kbloom/7-day-alarm-clock/(commit log)

2020-10-26 Write about changing the i2c address of the snooze button
2020-10-28 Create function prototypes, and reorder declarations to be more coherent.
2020-11-08 Print next alarm
2020-11-09 Time::operator== no longer compares the state field.
    This led to bugs before, so whenever we're care about the state field,
    we should check it explicitly.
2020-11-10 Change the alarm status display to show the weekday and status.
    This removes the alarm time, to prevent confusion with the current time.
    SetAlarm menu can now cycle through all time states.
2020-11-10 Make switch debounce times shorter.
2020-11-10 Print the remaining snooze time as part of the snoozing status message.
2020-11-11 Add shabbat alarms that trigger for one minute only, and don't respond to buttons.
2020-11-20 Bug Fix: make DoubleHighFont print spaces too.
    This way, space-padding actually works.
    [double_high_font.h]
2020-11-22 When exiting state SOUNDING_SHABBAT, drop all button input events.
2020-11-29 Techniques for decreasing the number of setCursor calls when using double_high_digits.h
    Decouple font installation from font writing, so that one can, for
    example write to a buffer class (that implements a partial LCD
    interface), while installing the characters directly on the LCD device..
    Implement write(const char* buffer, size_t size).
2020-11-29 Move PrintTime function into SetTime::Display, the only place it's used.
2020-11-29 Actually print the time faster.
2020-11-29 Print status identifying shabbat alarm when Shabbat alarm is sounding.
2020-12-04 Handle alarms, snooze buttons, and skip buttons while the menu is open.
2021-01-29 Make debounce times longer.
    Make the stop/skip button have a 1 second debounce time, since
    double clicking it is infrequent.
    Make the snooze button have a 200ms debounce time.
2021-01-31 Fix more compile warnings
    [double_high_digits.h]
2021-01-31 Fix more compile warnings
    Some of these affect actual functionality in the uploaded sketch in avr-gcc 10
    (which ships with Manjaro) while not causing problems in avr-gcc 7
    (which ships in the Arduino snap).
    [double_high_digits.h]
2021-12-02 Give the snooze button a long debounce time too.
    This morning I couldn't get it to give me 8 minute snoozes -- only 16 minute snoozes.
2021-12-02 Make the backlight a little bit more orange when one of the buttons is pressed.
2023-11-22 Switch to PlatformIO
2024-01-07 Add debug printing on state transitions.
    This happens to also solve a problem where the alarm
    was constantly restarting. I don't know why. Timing, I guess?
    [alarm_clock.cpp]
2024-09-30 Change alarm length to be length of the MP3.
    I wanted to shorten my alarms to 10 seconds or 30 seconds (since I never
    need a full 5 minute alarm, but if I forget about the alarm for Yom Tov,
    it wakes up my wife and she can't get back to sleep.)
    I couldn't find a reliable way to shorten my alarms down to that length
    aside from this. My current MP3 is about 20 seconds long.
    Also, the shabbat alarm is now F002.mp3, so you can use a different sound
    (or different duration) than the weekday alarm.
    [alarm_clock.cpp]
2024-09-30 More status debugging.
    When changing volume, output MP3 player status to serial.
    Print the state change when changing to WAITING.
2024-10-27 If the menu has been idle for 1 minute, cancel it.
    The toddler started playing with my alarm clock over a 3 day Yom Tov,
    and left it in menu mode until I could push more buttons after Shabbat.
    This protection ensures that if he plays with it again on Shabbat, it
    goes back to displaying the time. (Also, the menu color is too bright
    and is annoying when we're trying to sleep, so we really want it to go
    back to displaying red.)
2024-10-27 If menu times out during time entry, let subsequent calls to ReadChar timeout immediately, taking us back to the clock screen immediately, even from deeply nested data input flows.
2024-10-28 Password bugfixes:
    We should accept the password based on the length of the string, and not
    hard-code the length, so use strlen_P.
    If the user enters the first character of the password after entering
    part of the correct password, we should reset to the state where the
    first character has been entered correctly, rather than expecting the
    user to enter the first character again. (We don't need to do this for
    other positions in the password, since we stipulated that the password
    should have no duplicate characters.)
    [alarm_clock.cpp]
2025-03-18 Copy the status codes comment to the other place we print the status code, too.
2025-12-16 When printing the main display, always fill every cell.
    This adds padding to the writes in PrintTimeTall, so that every time
    through the display loop we write to every cell in the display. This
    overwrites the garbage characters that occasionally appear on the
    display. I don't know why this happens, but it improved a lot when I cut
    some of the I2C pull-up resistors, and then it reappeared when the
    weather got cold and dry.
2026-06-11 Change the button driver to a custom Button class that handles direct-wire buttons.
2026-06-18 Update the readme to not talk about Qwiic buttons
2026-07-10 Better debounce logic.
    My arcade button can bounce on press and release, and bounce on release
    can trigger a FALLING interrupt. In order to prevent a false press when
    the button is released, the debounce time needed to be longer than the
    user holds the button for, so that the debounce on the press would also
    cover the release.
    A better solution is to interrupt on CHANGE, and read whether the pin is
    high or low as the first step in the interrupt handler. (Hopefully this
    is always correct, though I suppose bounce timing can can in some
    circumstances cause the read to be different from the change that
    triggered the interrupt.)
    The last complication is that now the Button class can respond to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
    [alarm_clock.cpp]
2026-07-10 Button::checkAndClear should apparently not be atomic
    See comment.
2026-07-10 Remove I2C addresses for buttons, which are no longer I2C.
    [alarm_clock.cpp]
2026-07-10 Explain why I stopped using Qwiic arcade buttons.
2026-07-12 Revert "Button::checkAndClear should apparently not be atomic"
    This reverts commit 8a43c87a5fc4a39c695b328ce4131939164ffc53.
    I'm reverting both commits that change debounce behavior, since after a
    little more testing, apparently both ways may record 4 snooze button
    presses when I only pressed it 3 times. We're back to 1 second debounce
    times.
    [alarm_clock.cpp]
2026-07-12 Revert "Better debounce logic."
    This reverts commit 6c787352afdeb2f91d152a3fe4a96c60bc32102c.
    [alarm_clock.cpp]
